Sutej2907/Maze_Solver_PCB/HSM_Symbols/SFH_4545/SFH_4545.step

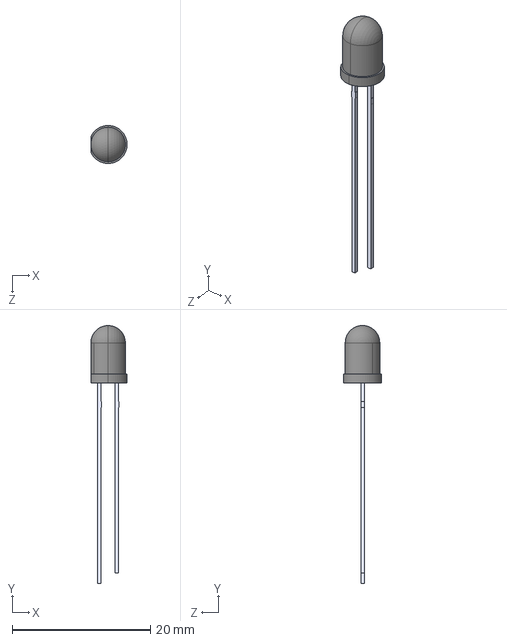
[picture p1: CAD file, 2026-04-08]
HSM_Symbols/SFH_4545/SFH_4545.step
5.25 x 37.3 x 5.50 mm
