Sutej2907/Maze_Solver_PCB/HSM_Symbols/SFH_4550/SFH_4550.step

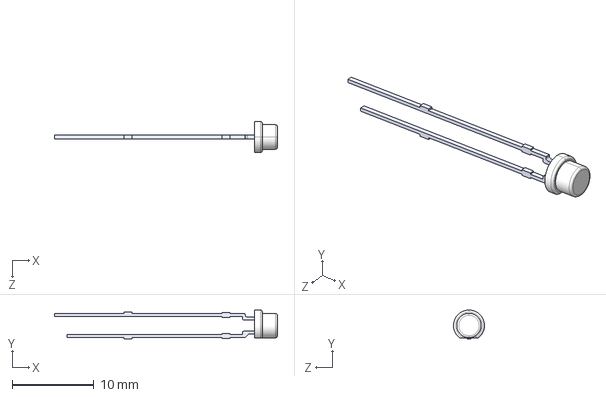
[picture p2: CAD file, 2026-05-27]
HSM_Symbols/SFH_4550/SFH_4550.step
27.3 x 3.55 x 3.80 mm
