Sutej2907/Maze_Solver_PCB/HSM_Symbols/TEENSY_4.1/G73 button.STEP

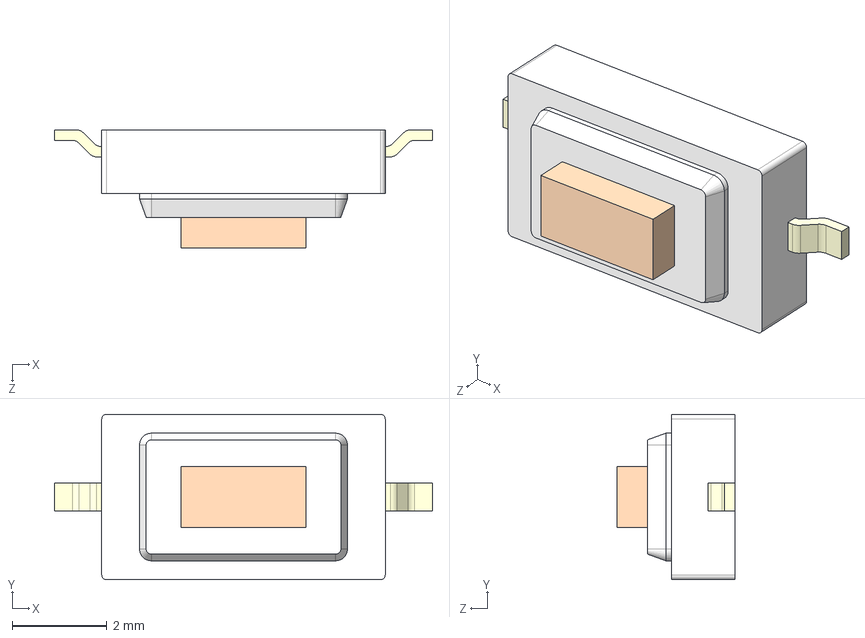
[picture p3: CAD file, 2026-05-02]
HSM_Symbols/TEENSY_4.1/G73 button.STEP
8.00 x 3.50 x 2.50 mm
