Sutej2907/Maze_Solver_PCB/HSM_Symbols/TEFT4300 (2)/TEFT4300.step

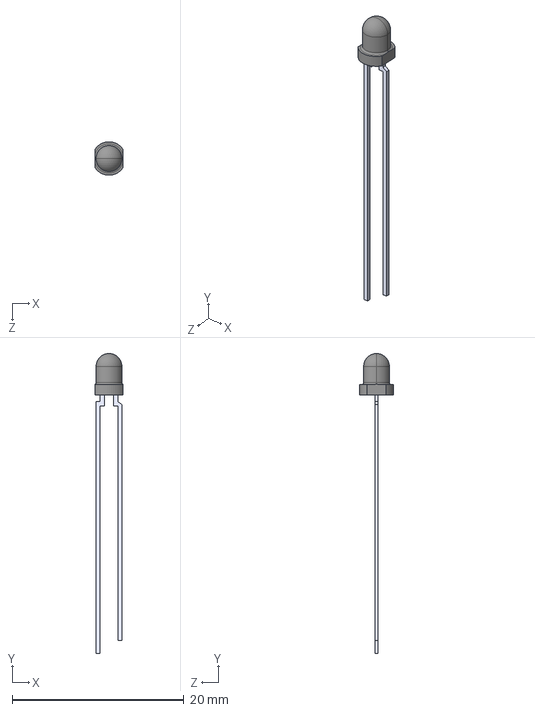
[picture p4: CAD file, 2026-04-08]
HSM_Symbols/TEFT4300 (2)/TEFT4300.step
3.20 x 34.9 x 3.90 mm
