Sutej2907/Maze_Solver_PCB/HSM_Symbols/TEENSY_4.1/Teensy 4.1--3DModel-STEP-269445.STEP

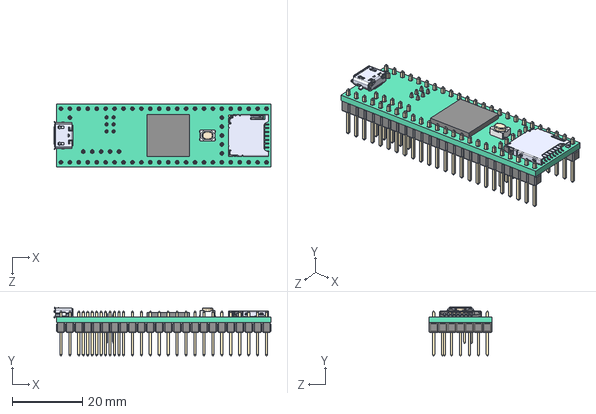
[picture p5: CAD file, 2026-05-02]
HSM_Symbols/TEENSY_4.1/Teensy 4.1--3DModel-STEP-269445.STEP
61.7 x 13.8 x 17.8 mm
