Sutej2907/Maze_Solver_PCB/Hardware/HSM_Project.kicad_pcb

## KiCad design Hardware/HSM_Project.kicad_pcb (2026-06-01)

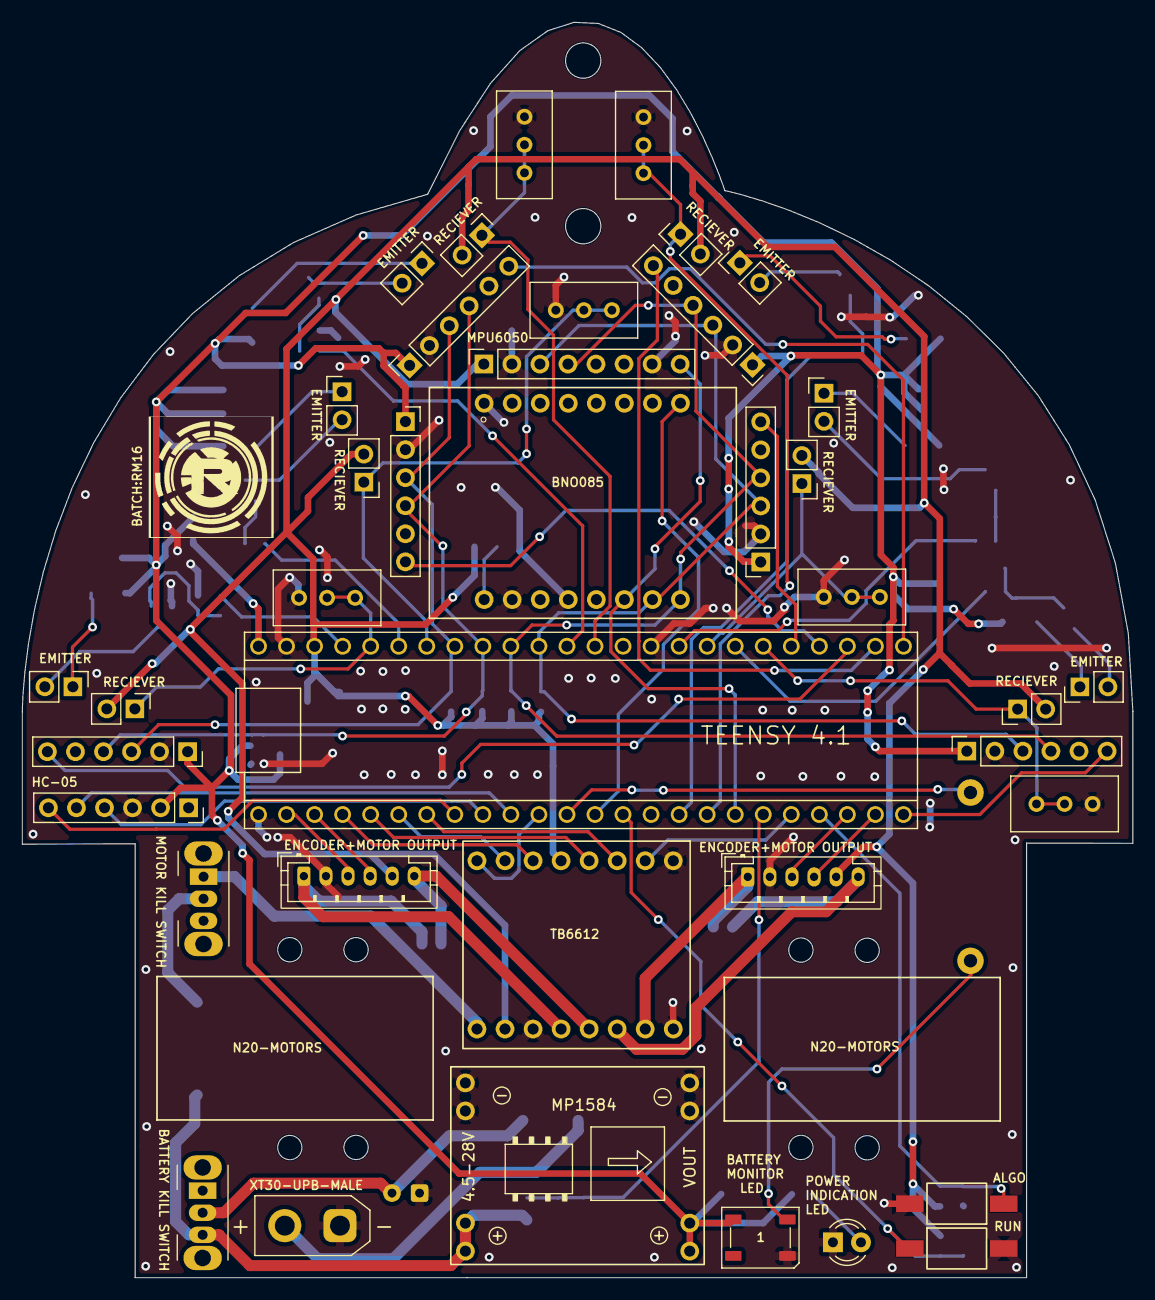
[picture p6: board HSM_Project.kicad_pcb from above]

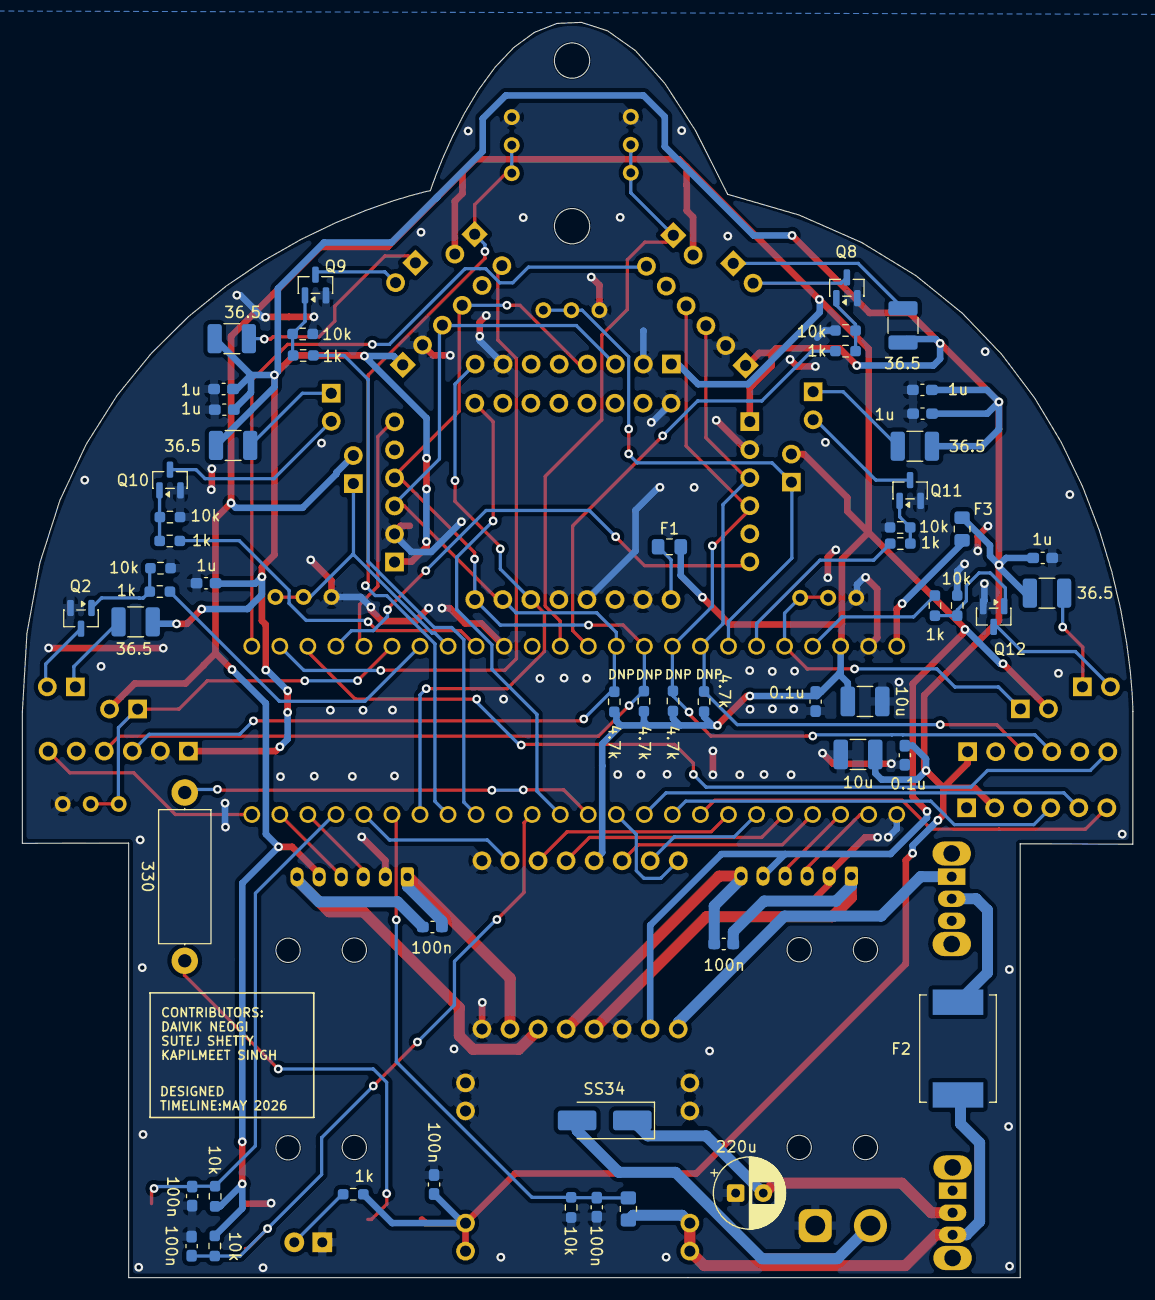
[picture p7: board HSM_Project.kicad_pcb from below]

Board: 2 copper layers, 100.6 x 113.7 mm, 104 parts (55 on the bottom side), 75 nets.

Parts:
C1, C2, C3, C11, C12, C13: 1u; C_0603_1608Metric_Pad1.08x0.95mm_HandSolder
C4, C6: 0.1u; C_0603_1608Metric_Pad1.08x0.95mm_HandSolder
C5, C7: 10u; C_1210_3225Metric_Pad1.33x2.70mm_HandSolder
C8, C9, C16, C17, C21, C22: 100n; C_0603_1608Metric_Pad1.08x0.95mm_HandSolder
C10: 220u; CP_Radial_D6.3mm_P2.50mm
D1, D4, D6, D7, D8, D9: SFH_4550; SFH4550_HEADER
D2: SS34; D_SMA_Handsoldering
D3: LED; LED_D3.0mm_micromouse
D5: WS2812B; LED_WS2812B_PLCC4_5.0x5.0mm_P3.2mm
F1, F3: Polyfuse; Fuse_0805_2012Metric_Pad1.15x1.40mm_HandSolder
F2: Polyfuse; Fuse_Bourns_MF-SM_9.5x6.71mm
H1, H2, H3, H4, H5, H6, H7, H8: MountingHole; MountingHole_2.2mm_M2
H9, H10: MountingHole; MountingHole_3.2mm_M3
J1: Conn_01x02_Pin; AMASS_XT30UPB-M_1x02_P5.0mm_Vertical
J2: MP1584 Breakout; MP1584
J4: TEENSY_4.1; TEENSY_LONG_EXT
J5: Conn_01x08_Pin; PinSocket_1x08_P2.54mm_Vertical
J6, J7: Conn_01x06_Pin; JST_PH_B6B-PH-K_1x06_P2.00mm_Vertical
J8, J9, J10, J11, J12, J13: VL530X Connector; PinSocket_1x06_P2.54mm_Vertical
J14: BNO085 Breakout; BNO085
J16: HC-05 Breakout Board; PinSocket_1x06_P2.54mm_Vertical
Q2, Q8, Q9, Q10, Q11, Q12: Q_NMOS_GSD; SOT-23
Q3, Q4, Q5, Q6, Q7, Q13: SFH_313_FA-3_4; SFH313_Header
R2, R7, R32, R33, R34, R35, R36, R37, R38: 10k; R_0603_1608Metric_Pad0.98x0.95mm_HandSolder
R3, R9, R15, R17, R19, R21, R28: 1k; R_0603_1608Metric_Pad0.98x0.95mm_HandSolder
R4: 330; R_Axial_DIN0414_L11.9mm_D4.5mm_P15.24mm_Horizontal
R5, R23, R24, R30: 4.7k; R_0603_1608Metric_Pad0.98x0.95mm_HandSolder
R6: 30k; R_0805_2012Metric_Pad1.20x1.40mm_HandSolder
R8, R16, R18, R20, R22, R29: 36.5; R_1210_3225Metric_Pad1.30x2.65mm_HandSolder
RV1, RV2, RV3, RV4, RV5, RV6: R_Potentiometer_Trim; Potentiometer_Bourns_3296W_Vertical
SW2, SW5: SW_SPDT; SW_Slide_SPDT_Angled_CK_OS102011MA1Q
SW3, SW4: SW_Push; Rectangular Tact Button
TB1: TB6612 Breakout Board; TB6612 module

Connections:
+3.3V: C6.1, C7.1, F1.2, J4.3V3 (3.3V), J5.1, J6.5, J7.5, Q3.2, Q4.2, Q5.2, Q6.2, Q7.2, Q13.2, R2.1, R5.1, R23.1, R24.1, R30.1, R33.1, TB1.5 (STBY), TB1.15 (VCC)
+5V: C1.1, C2.1, C3.1, C4.1, C5.1, C9.1, C11.1, C12.1, C13.1, D5.1 (VDD), F3.1, J2.7 (OUT+), J2.8 (OUT+), J8.1 (VCC), J9.1 (VCC), J10.1 (VCC), J11.1 (VCC), J12.1 (VCC), J13.1 (VCC), J16.2 (VCC), R3.1, R8.1, R16.1, R18.1, R20.1, R22.1, R29.1
/Control Unit/ALGO_CONTROL: C17.2, J4.D29, R2.2, SW3.1
/Control Unit/BATTERY_LED: J4.D10 ((CS)D10), R4.1
/Control Unit/BT_RX: J4.D7, J16.4 (TXD)
/Control Unit/BT_TX: J4.D8, J16.5 (RXD)
/Control Unit/EMIITER_FRONT_2: J4.D23 (A9), R28.2
/Control Unit/EMITTER_FRONT: J4.D39 (A15), R9.2
/Control Unit/EMITTER_FRONT_LEFT: J4.D15 (A1), R15.2
/Control Unit/EMITTER_FRONT_RIGHT: J4.D24 (A10), R17.2
/Control Unit/EMITTER_LEFT: J4.D21 (A7), R21.2
/Control Unit/EMITTER_RIGHT: J4.D41 (A17), R19.2
/Control Unit/ENC1_A: J4.D0 ((CRX1)D0), J6.3
/Control Unit/ENC1_B: J4.D1 ((CTX1)D1), J6.4
/Control Unit/ENC2_A: J4.D30, J7.3
/Control Unit/ENC2_B: J4.D31, J7.4
/Control Unit/INT_GPIO: J4.D26 (A12), J5.8, J14.11 (INT)
/Control Unit/M1_INPUT1: J4.D2, TB1.6 (AIN1)
/Control Unit/M1_INPUT2: J4.D4, TB1.7 (AIN2)
/Control Unit/M2_INPUT1: J4.D3, TB1.4 (BIN1)
/Control Unit/M2_INPUT2: J4.D5, TB1.3 (BIN2)
/Control Unit/RST_GPIO: J4.D11 ((SDO)D11), J14.8 (RST)
/Control Unit/RUN_MODE_GPIO: C16.2, J4.D12 ((SDI)D12), R33.2, SW4.1
/Control Unit/SCL0: J4.D19 (A5), J9.3 (SCL), J12.3 (SCL), J13.3 (SCL), R24.2
/Control Unit/SCL1: J4.D16 (A2), J5.3, J8.3 (SCL), J10.3 (SCL), J11.3 (SCL), J14.10 (SCL), R30.2
/Control Unit/SDA0: J4.D18 (A4), J9.4 (SDA), J12.4 (SDA), J13.4 (SDA), R23.2
/Control Unit/SDA1: J4.D17 (A3), J5.4, J8.4 (SDA), J10.4 (SDA), J11.4 (SDA), J14.9 (SDA), R5.2
/Control Unit/SENSE_FRONT_2: J4.D22 (A8), Q13.1, RV6.1, RV6.2
/Control Unit/SENS_FRONT: J4.D38 (A14), Q3.1, RV1.1, RV1.2
/Control Unit/SENS_FRONT_LEFT: J4.D14 (A0), Q4.1, RV2.1, RV2.2
/Control Unit/SENS_FRONT_RIGHT: J4.D25 (A11), Q5.1, RV3.1, RV3.2
/Control Unit/SENS_LEFT: J4.D20 (A6), Q7.1, RV5.1, RV5.2
/Control Unit/SENS_RIGHT: J4.D40 (A16), Q6.1, RV4.1, RV4.2
/Control Unit/STATE_HC-05: J4.D6, J16.6 (STATE)
/Control Unit/VBAT_MONITOR: C8.1, J4.D27 (A13), R6.2, R7.2
/Control Unit/XSHUT_TOF1: J4.D32, J8.6 (XSHUT)
/Control Unit/XSHUT_TOF2: J4.D33, J9.6 (XSHUT)
/Control Unit/XSHUT_TOF3: J4.D34, J10.6 (XSHUT)
/Control Unit/XSHUT_TOF4: J4.D35, J13.6 (XSHUT)
/Control Unit/XSHUT_TOF5: J4.D36, J12.6 (XSHUT)
/Control Unit/XSHUT_TOF6: J4.D37, J11.6 (XSHUT)
/Power Unit/M1_OUT1: C21.2, J6.1, TB1.13 (M1Out+)
/Power Unit/M1_OUT2: C21.1, J6.6, TB1.12 (M1Out-)
/Power Unit/M2_OUT1: C22.2, J7.1, TB1.10 (M2Out+)
/Power Unit/M2_OUT2: C22.1, J7.6, TB1.11 (M2Out-)
GND: C1.2, C2.2, C3.2, C4.2, C5.2, C6.2, C7.2, C8.2, C9.2, C10.1, C11.2, C12.2, C13.2, C16.1, C17.1, D3.1 (K), D5.3 (VSS), J1.1, J2.3 (IN-), J2.4 (IN-), J2.5 (OUT-), J2.6 (OUT-), J4.AGND/GND (GND), J4.GND, J4.GND@2 (GND), J5.2, J5.7, J6.2, J7.2, J8.2 (GND), J9.2 (GND), J10.2 (GND), J11.2 (GND), J12.2 (GND), J13.2 (GND), J14.1 (GND), J14.12 (PS0), J14.13 (PS1), J14.15 (GND), J16.3 (GND), Q2.2 (S), Q8.2 (S), Q9.2 (S), Q10.2 (S), Q11.2 (S), Q12.2 (S), R7.1, R32.1, R34.2, R35.2, R36.2, R37.2, R38.2, RV1.3, RV2.3, RV3.3, RV4.3, RV5.3, RV6.3, SW3.2, SW4.2, TB1.1 (GND), TB1.9 (GND), TB1.14 (GND)
unnamed: D1.A, R16.2
unnamed: D2.2 (A), J1.2
unnamed: C10.2, D2.1 (K), SW2.2 (B)
unnamed: D3.2 (A), R3.2
unnamed: D4.A, R8.2
unnamed: D5.4 (DIN), R4.2
unnamed: D6.A, R18.2
unnamed: D7.A, R20.2
unnamed: D8.A, R22.2
unnamed: D9.A, R29.2
unnamed: F1.1, J14.16 (3V3)
unnamed: F3.2, J4.VIN
unnamed: D4.C, Q2.3 (D)
unnamed: Q2.1 (G), R9.1, R32.2
unnamed: D1.C, Q8.3 (D)
unnamed: Q8.1 (G), R15.1, R34.1
unnamed: D6.C, Q9.3 (D)
unnamed: Q9.1 (G), R17.1, R35.1
unnamed: D7.C, Q10.3 (D)
unnamed: Q10.1 (G), R19.1, R36.1
unnamed: D8.C, Q11.3 (D)
unnamed: Q11.1 (G), R21.1, R37.1
unnamed: D9.C, Q12.3 (D)
unnamed: Q12.1 (G), R28.1, R38.1
unnamed: SW5.1 (A), TB1.16 (VM)
unnamed: F2.2, SW5.2 (B)
PWMA: J4.D9, TB1.8 (PWMA)
PWMB: J4.D28, TB1.2 (PWMB)
VBAT: F2.1, J2.1 (IN+), J2.2 (IN+), R6.1, SW2.3 (C)
