Sutej2907/Maze_Solver_PCB/(commit log)

2026-04-07 Updated the sensor sheet by adding soldern jumpers for xshut for tof sensors, also corrected the motor sheet and mcu sheet
    [Bluetooth.kicad_sch, HSM_Project.kicad_pcb, HSM_Project.kicad_sch, IMU.kicad_sch, MCU.kicad_sch, Motors.kicad_sch, Power.kicad_sch, Sensors.kicad_sch]
2026-04-07 Created Hardware folder
    [Sensors.kicad_sch]
2026-04-08 Reorganized project into folders
    [Bluetooth.kicad_sch, HC-05.step, HSM_Project.kicad_pcb, HSM_Project.kicad_sch, IMU.kicad_sch, MCU.kicad_sch, Motors.kicad_sch, Power.kicad_sch]
2026-04-08 Added .gitignore for KiCad project
2026-04-08 Completed schematic design
2026-04-08 Schematic updated with buck and motor driver breakout boards
    [Bluetooth.kicad_sch, HC-05.step, HSM_Project.kicad_sch, MCU.kicad_sch, Power.kicad_sch, Sensors.kicad_sch]
2026-04-12 Switches changed,added low pass filters, emitter caps
    [MCU.kicad_sch, Power.kicad_sch, Sensors.kicad_sch]
2026-04-14 Added KiCad PCB files
    [HSM_Project.kicad_pcb, MCU.kicad_sch, Power.kicad_sch, Sensors.kicad_sch]
2026-04-17 Added the mounting holes, kill iwtch for the moto,removed resistors from xshut, and some others
    [HSM_Project.kicad_pcb, MCU.kicad_sch, Power.kicad_sch, Sensors.kicad_sch]
2026-04-18 1)PCB tracing continued, power traces need to verified,signal traces almost done except xshut, need to verify drv8833 dimesnions, should resolve teensy 4.1 error, switches footprint need to be change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
    [HSM_Project.kicad_pcb, HSM_Project.kicad_sch, MCU.kicad_sch, Power.kicad_sch, Sensors.kicad_sch]
2026-04-19 PCB tracing, rectified most of the errors and warnings in drc,updated the drv8833 footprint and have to replace it will old footprint in the pcb, need to rectify the little left over error[4] and war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
    [HSM_Project.kicad_pcb]
2026-05-01 Final updated pcb and schematic before dfm check
    [Bluetooth.kicad_sch, HSM_Project.kicad_pcb, HSM_Project.kicad_sch, IMU.kicad_sch, MCU.kicad_sch, Motors.kicad_sch, Power.kicad_sch, Sensors.kicad_sch]
2026-05-01 Final schematic and pcb before dfm check
2026-05-02 Ignore KiCad .history folder
    [G73 button.STEP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]
2026-05-02 Removed KiCad .history folder completely
2026-05-21 updated the dimensiosn of tb6612,shifted placements based on dfm check, other changes
    [HSM_Project-B_Cu.gbl, HSM_Project-B_Mask.gbs, HSM_Project-B_Paste.gbp, HSM_Project-B_Silkscreen.gbo, HSM_Project-Edge_Cuts.gm1, HSM_Project-F_Cu.gtl, HSM_Project-F_Mask.gts, HSM_Project-F_Paste.gtp]
2026-05-21 Ignore KiCad backup zip files
2026-05-21 Ignore KiCad temp files
2026-05-21 Removed tracked KiCad temp files
2026-05-27 Updated PCB files after dfm check
    [HSM_Project-B_Cu.gbl, HSM_Project-B_Mask.gbs, HSM_Project-B_Paste.gbp, HSM_Project-B_Silkscreen.gbo, HSM_Project-Edge_Cuts.gm1, HSM_Project-F_Cu.gtl, HSM_Project-F_Mask.gts, HSM_Project-F_Paste.gtp]
2026-05-28 Made changes with i2c bus, added state connection and removed en of hc05, added bno085 fuse,bno085 2nd 3v3 unconnected flag has been put, reversed the connection for battery connector based on the xt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
    [HSM_Project-B_Cu.gbl, HSM_Project-B_Mask.gbs, HSM_Project-B_Paste.gbp, HSM_Project-B_Silkscreen.gbo, HSM_Project-Edge_Cuts.gm1, HSM_Project-F_Cu.gtl, HSM_Project-F_Mask.gts, HSM_Project-F_Paste.gtp]
2026-05-28 Added KiCad backup files
    [HSM_Project-B_Cu.gbl, HSM_Project-B_Mask.gbs, HSM_Project-B_Paste.gbp, HSM_Project-B_Silkscreen.gbo, HSM_Project-Edge_Cuts.gm1, HSM_Project-F_Cu.gtl, HSM_Project-F_Mask.gts, HSM_Project-F_Paste.gtp]
2026-05-28 Removed KiCad .history folder from tracking
2026-05-28 Clean repository and ignore KiCad temp/history files
2026-06-01 Updated the ootprint of emitter and reciver to pinheader, largened the logo
    [HSM_Project-B_Cu.gbl, HSM_Project-B_Mask.gbs, HSM_Project-B_Paste.gbp, HSM_Project-B_Silkscreen.gbo, HSM_Project-Edge_Cuts.gm1, HSM_Project-F_Cu.gtl, HSM_Project-F_Mask.gts, HSM_Project-F_Paste.gtp]
2026-06-01 Clean repository and update PCB design
    [HSM_Project-B_Cu.gbl, HSM_Project-B_Mask.gbs, HSM_Project-B_Paste.gbp, HSM_Project-B_Silkscreen.gbo, HSM_Project-Edge_Cuts.gm1, HSM_Project-F_Cu.gtl, HSM_Project-F_Mask.gts, HSM_Project-F_Paste.gtp]
2026-06-01 Update gitignore and PCB files
    [HSM_Project.kicad_pcb, Power.kicad_sch]
